aditishreyavsl-web/rv32_pipeline_openlane/rtl/rv32_alu.v

// RV32I ALU (combinational)
module rv32_alu (
    input  wire [31:0] a,
    input  wire [31:0] b,
    input  wire [3:0]  op,
    output reg  [31:0] y
);
    localparam ALU_ADD   = 4'd0;
    localparam ALU_SUB   = 4'd1;
    localparam ALU_SLL   = 4'd2;
    localparam ALU_SLT   = 4'd3;
    localparam ALU_SLTU  = 4'd4;
    localparam ALU_XOR   = 4'd5;
    localparam ALU_SRL   = 4'd6;
    localparam ALU_SRA   = 4'd7;
    localparam ALU_OR    = 4'd8;
    localparam ALU_AND   = 4'd9;
    localparam ALU_PASSB = 4'd10;

    always @* begin
        case (op)
            ALU_ADD:   y = a + b;
            ALU_SUB:   y = a - b;
            ALU_SLL:   y = a << b[4:0];
            ALU_SLT:   y = ($signed(a) < $signed(b)) ? 32'd1 : 32'd0;
            ALU_SLTU:  y = (a < b) ? 32'd1 : 32'd0;
            ALU_XOR:   y = a ^ b;
            ALU_SRL:   y = a >> b[4:0];
            ALU_SRA:   y = $signed(a) >>> b[4:0];
            ALU_OR:    y = a | b;
            ALU_AND:   y = a & b;
            ALU_PASSB: y = b;
            default:   y = 32'd0;
        endcase
    end
endmodule
